Abdulhamid-Baghdadi/robot-milling-dust-extractor/cad/Suction_cup.SLDASM

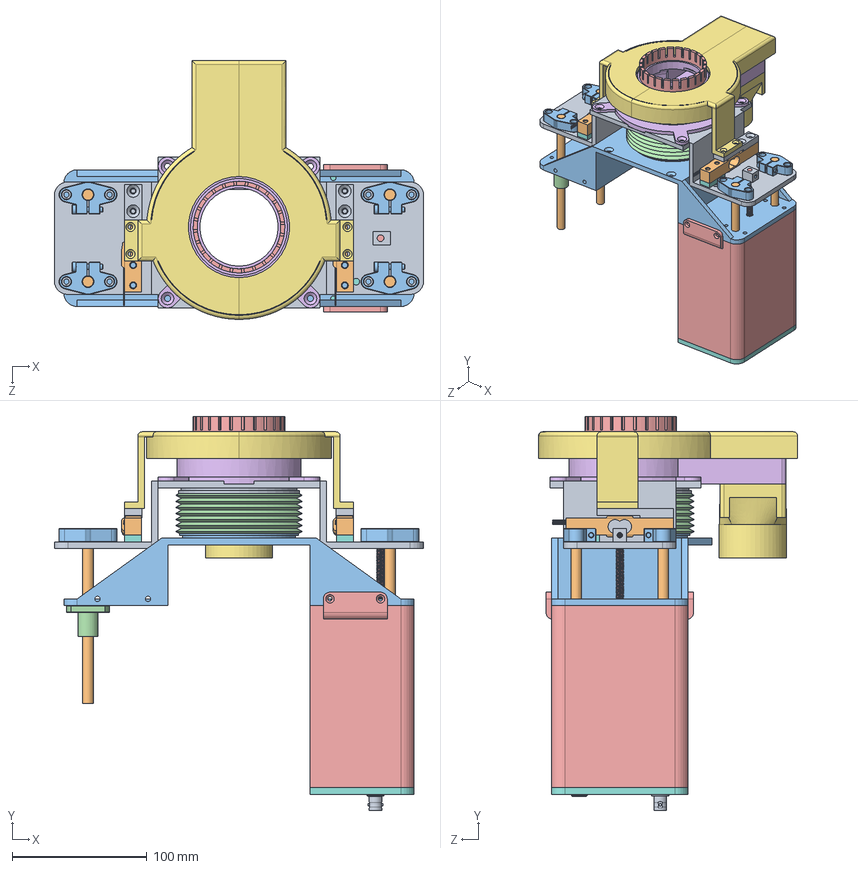
[picture p22: CAD file, 2026-10-20]
cad/Suction_cup.SLDASM
274.0 x 292.3 x 192.0 mm
Vacuum_stage
Rail x 4
Absaugung
LMH8UU x 4
Threaded Rod
LA351S12-A-UIEV.stp
Sensor
Weight_sensor_spacer x 2
Weight_sensor_carrier x 2
load_cell_sensor_FHD x 2
SHF8 x 4
TB6600 - Driver Motor de Passo 4A.stp
Lid
Dust_Inlet
Tube-connector
Electronics-lid
Amphenal_031_10_RFXG1
lumberg_1610_05.stp
m3_threaded_insert.stp
Tube
Besen
