Abdulhamid-Baghdadi/robot-milling-dust-extractor/cad/Vacuum_stage.SLDPRT

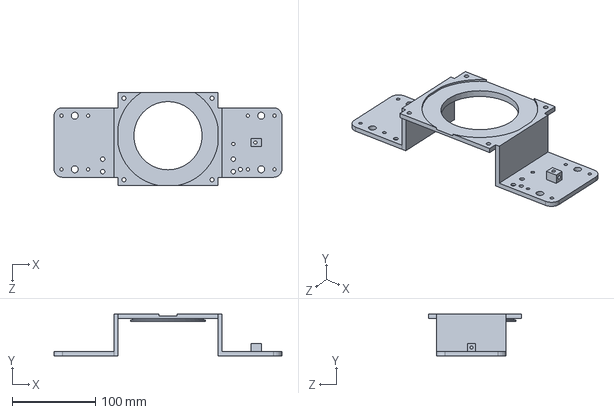
[picture p23: CAD file, 2026-10-20]
cad/Vacuum_stage.SLDPRT
274.0 x 50.0 x 112.0 mm
