Abdulhamid-Baghdadi/robot-milling-dust-extractor/cad/Tube-connector.SLDPRT

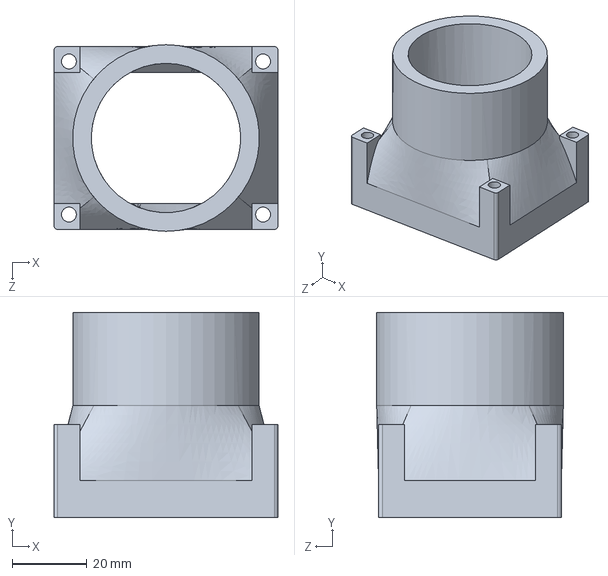
[picture p24: CAD file, 2026-10-20]
cad/Tube-connector.SLDPRT
60.0 x 55.0 x 50.0 mm
