Abdulhamid-Baghdadi/robot-milling-dust-extractor/cad/Sensor.SLDPRT

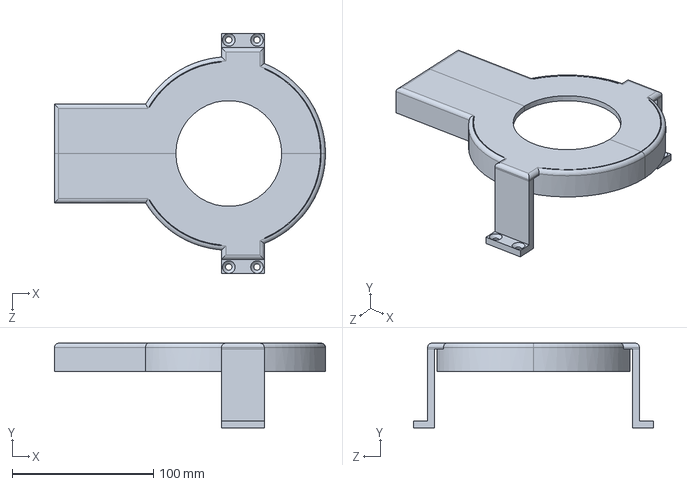
[picture p25: CAD file, 2026-10-20]
cad/Sensor.SLDPRT
192.0 x 60.0 x 170.0 mm
