Abdulhamid-Baghdadi/robot-milling-dust-extractor/cad/Tube.SLDPRT

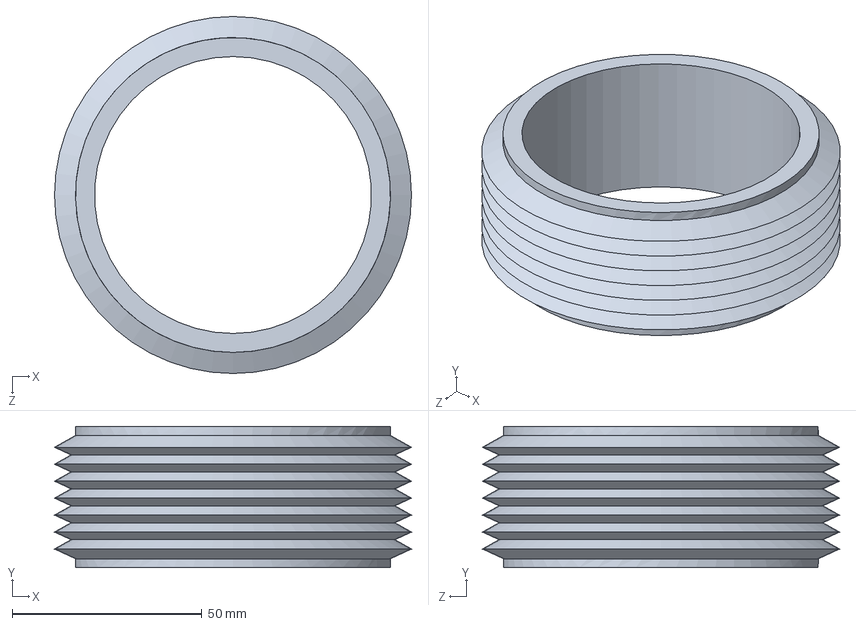
[picture p26: CAD file, 2026-10-20]
cad/Tube.SLDPRT
94.1 x 37.3 x 94.1 mm
