Abdulhamid-Baghdadi/robot-milling-dust-extractor/cad/Besen.SLDPRT

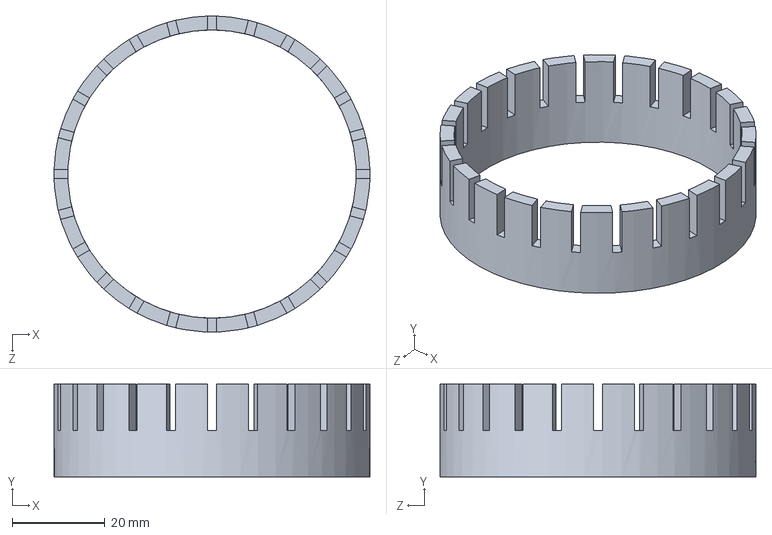
[picture p27: CAD file, 2026-10-20]
cad/Besen.SLDPRT
68.0 x 20.0 x 68.0 mm
