Abdulhamid-Baghdadi/robot-milling-dust-extractor/cad/Weight_sensor_carrier.SLDPRT

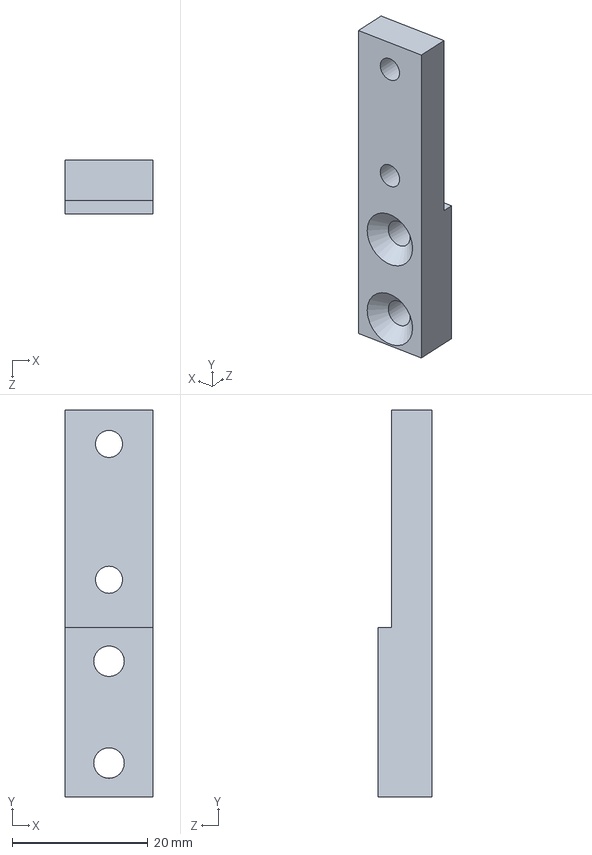
[picture p28: CAD file, 2026-10-20]
cad/Weight_sensor_carrier.SLDPRT
13.0 x 57.0 x 8.00 mm
