Abdulhamid-Baghdadi/robot-milling-dust-extractor/cad/Lid.SLDPRT

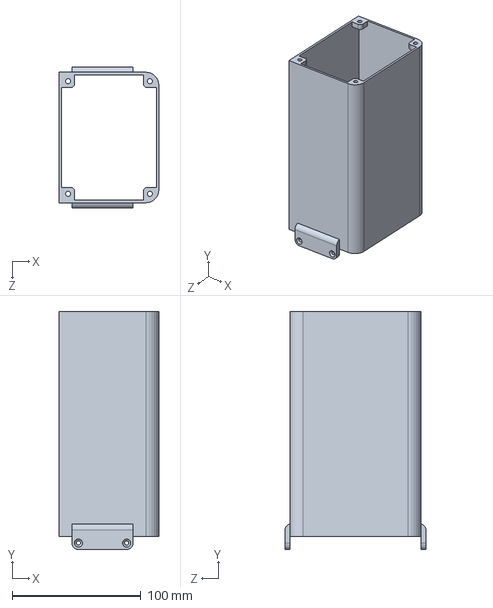
[picture p29: CAD file, 2026-10-20]
cad/Lid.SLDPRT
77.5 x 185.0 x 109.5 mm
