Abdulhamid-Baghdadi/robot-milling-dust-extractor/cad/Dust_Inlet.SLDPRT

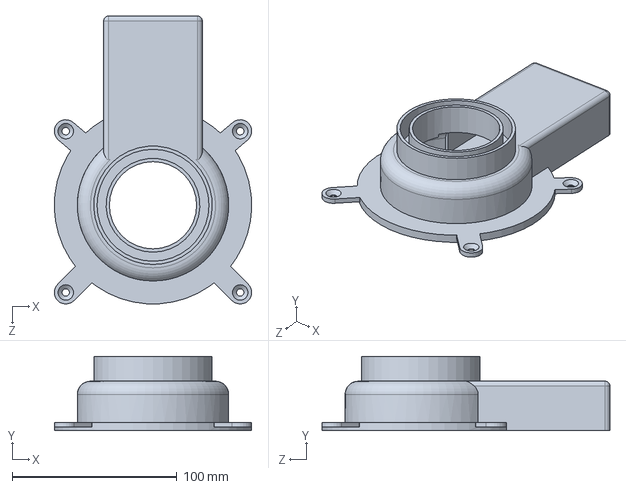
[picture p30: CAD file, 2026-10-20]
cad/Dust_Inlet.SLDPRT
120.0 x 45.0 x 175.0 mm
