Abdulhamid-Baghdadi/robot-milling-dust-extractor/cad/Rail.SLDPRT

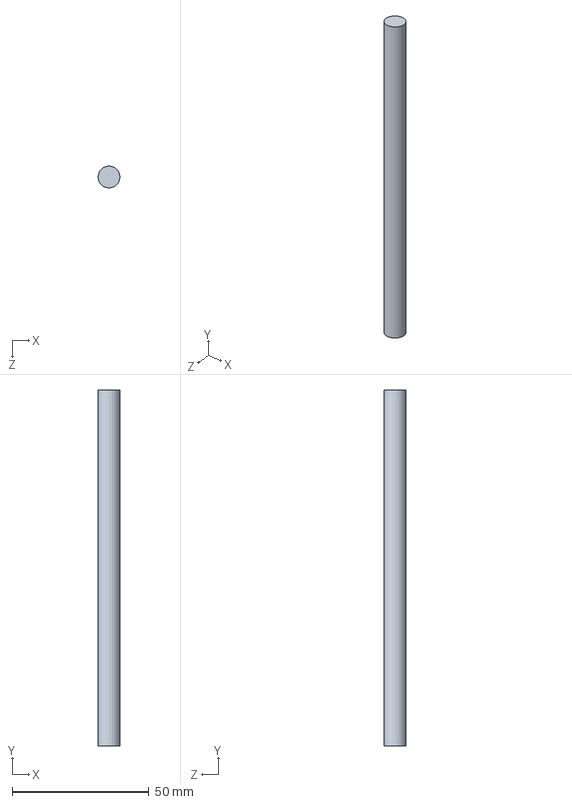
[picture p31: CAD file, 2026-10-20]
cad/Rail.SLDPRT
8.00 x 130.0 x 8.00 mm
