Abdulhamid-Baghdadi/robot-milling-dust-extractor/cad/Electronics-lid.SLDPRT

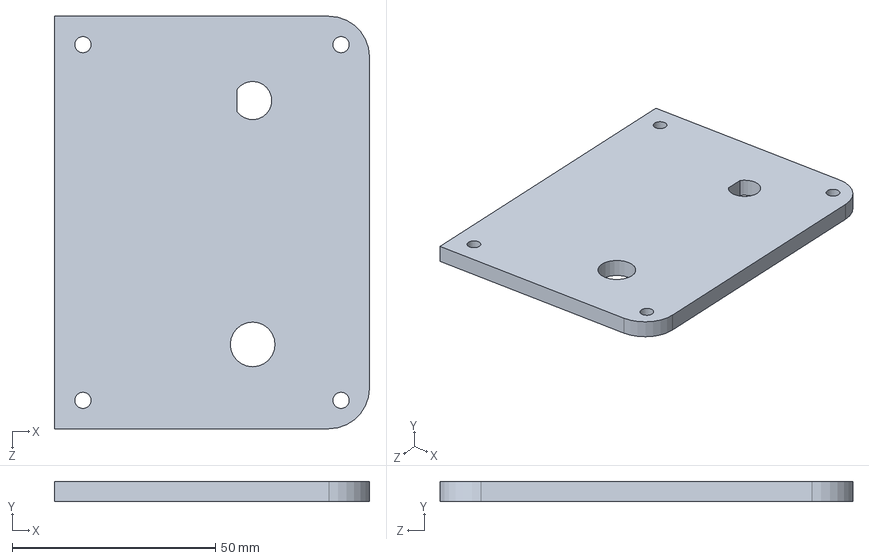
[picture p32: CAD file, 2026-10-20]
cad/Electronics-lid.SLDPRT
77.5 x 5.00 x 101.5 mm
