Abdulhamid-Baghdadi/robot-milling-dust-extractor/cad/Absaugung.SLDPRT

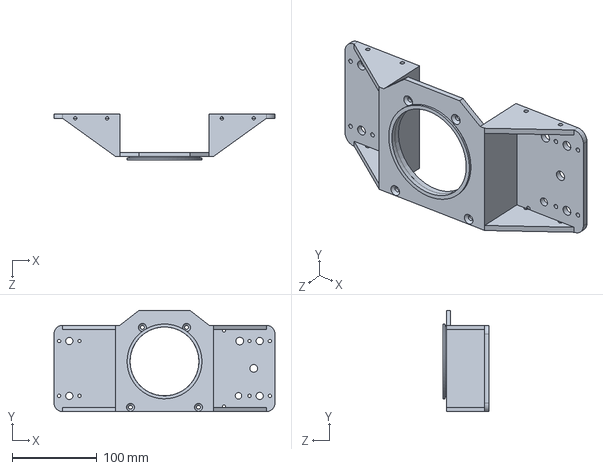
[picture p33: CAD file, 2026-10-20]
cad/Absaugung.SLDPRT
260.0 x 119.0 x 54.0 mm
