Abdulhamid-Baghdadi/robot-milling-dust-extractor/cad/Weight_sensor_spacer.SLDPRT

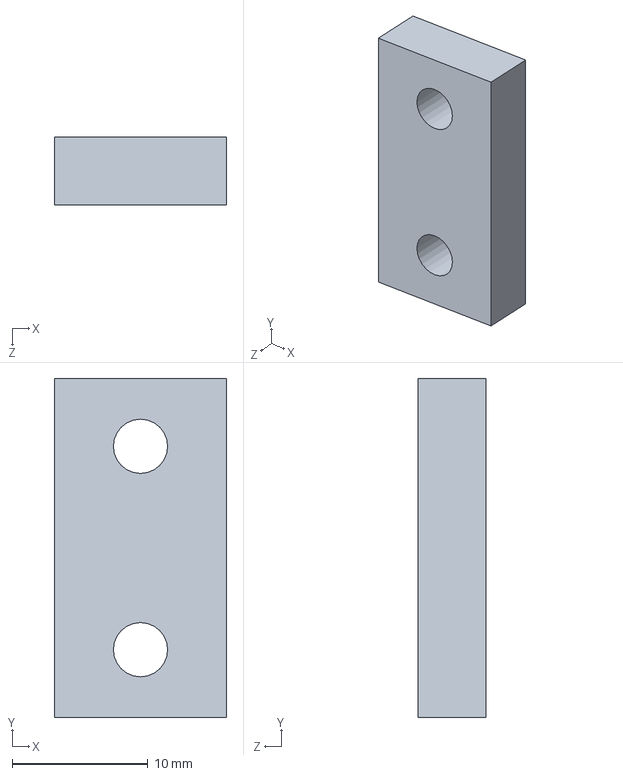
[picture p34: CAD file, 2026-10-20]
cad/Weight_sensor_spacer.SLDPRT
12.7 x 25.0 x 5.00 mm
