Abdulhamid-Baghdadi/robot-milling-dust-extractor/(list of files, cad)

Other CAD files:
cad/stl/Sensor.STL
cad/stl/Weight_sensor_carrier.STL
