Abdulhamid-Baghdadi/robot-milling-dust-extractor/docs/user-manual-de.pdf

# Bedienungsanleitung

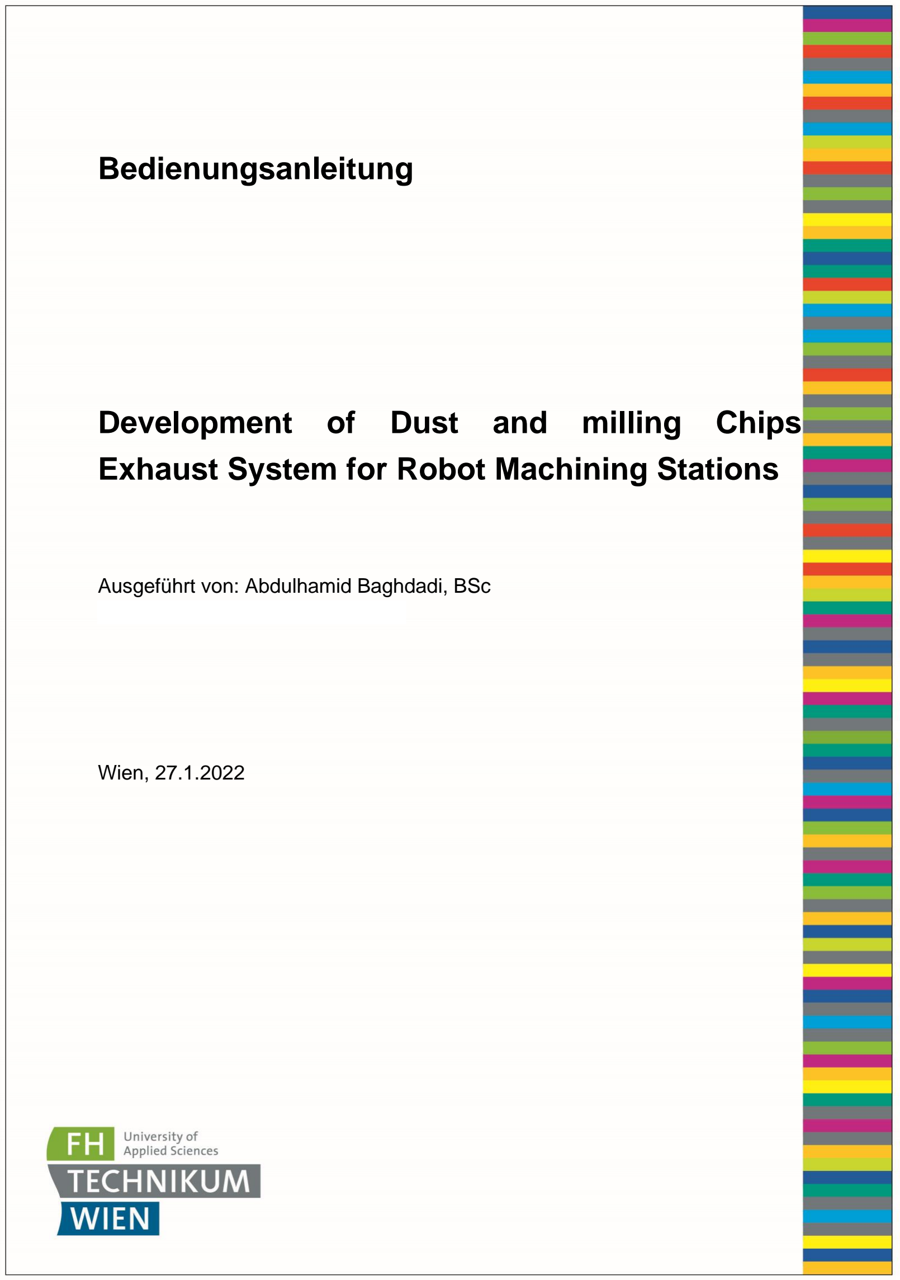
[picture p35: page 1]

# Development of Dust and milling Chips

# Exhaust System for Robot Machining Stations

Ausgeführt von: Abdulhamid Baghdadi, BSc

Wien, 27.1.2022

## Inhaltsverzeichnis

## 1 Montage des 3D gedruckten Models

In diesem Abschnitt sind die wichtigsten Schritte des Zusammenbauens der einzelnen Komponenten der Spänenabsaugung erläutert. Abbildung 1 Zeigt die Endform der Spänenabsaugung.

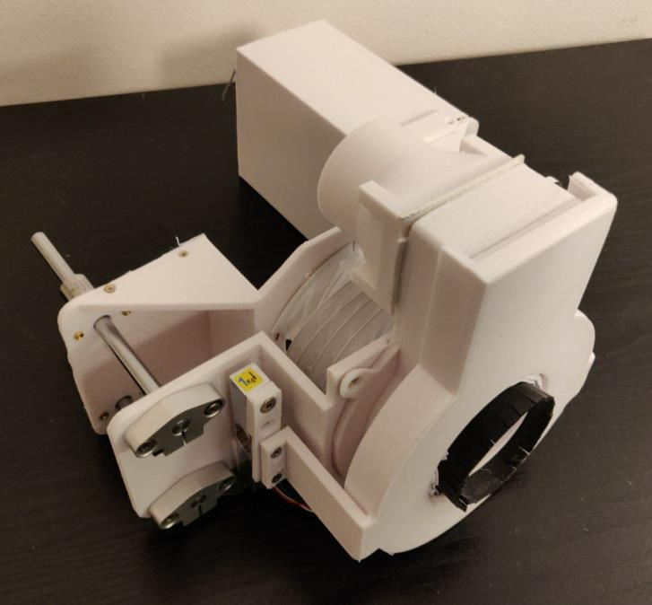
[picture p36: figure]

Abbildung 1: Zusammengebaute Spänenabsaugung

## 1.1 Hauptkörper

Die Linearführungen sowie der Schrittmotor und sein Kontroller sind mithilfe von M3 Gewindeeinsätze auf den Hauptkörper montiert.

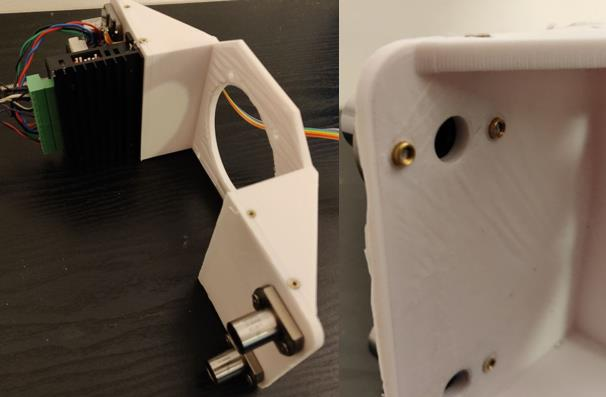
[picture p37: figure]

Abbildung 2: Hauptkörper

## 1.2 Bewegbarer Staubeinlass

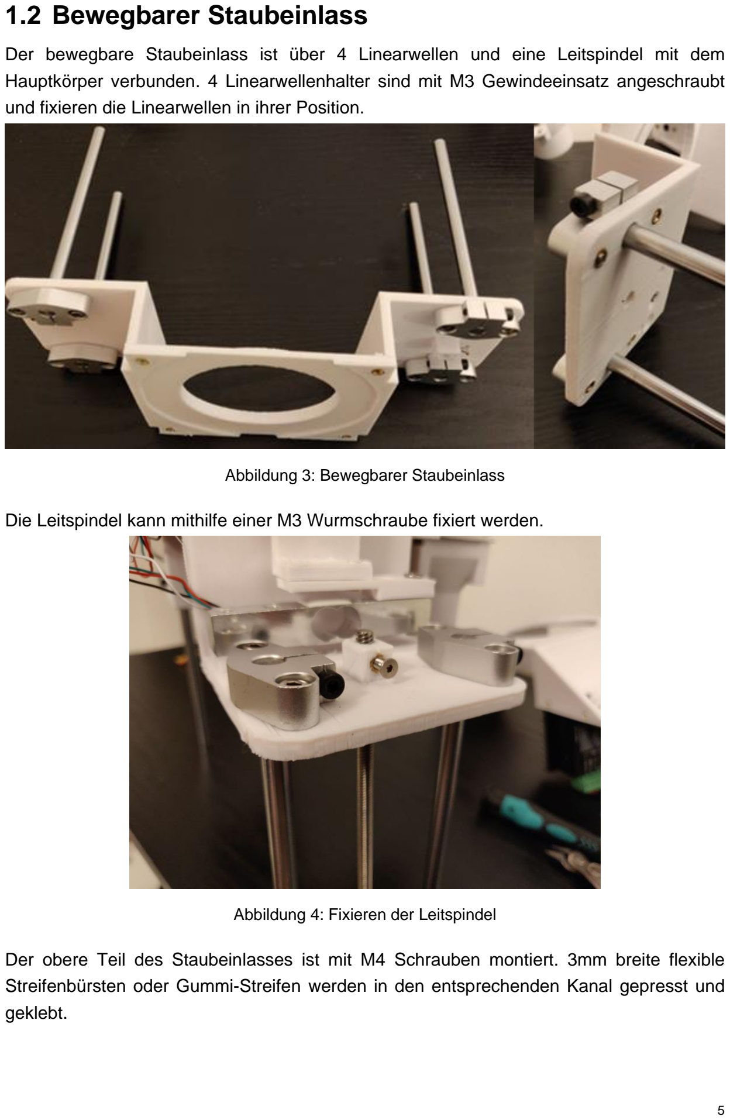
[picture p38: page 5]

Der bewegbare Staubeinlass ist über 4 Linearwellen und eine Leitspindel mit dem Hauptkörper verbunden. 4 Linearwellenhalter sind mit M3 Gewindeeinsatz angeschraubt und fixieren die Linearwellen in ihrer Position.

Abbildung 3: Bewegbarer Staubeinlass

Die Leitspindel kann mithilfe einer M3 Wurmschraube fixiert werden.

Abbildung 4: Fixieren der Leitspindel

Der obere Teil des Staubeinlasses ist mit M4 Schrauben montiert. 3mm breite flexible Streifenbürsten oder Gummi-Streifen werden in den entsprechenden Kanal gepresst und geklebt.

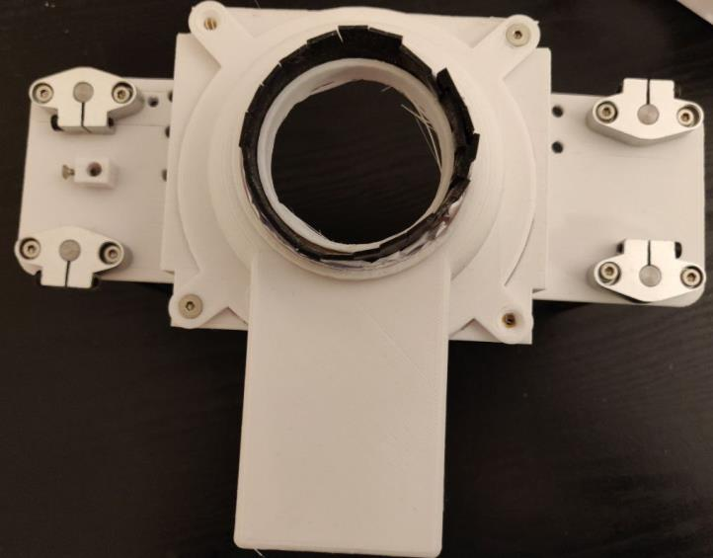
[picture p39: figure]

Abbildung 5: Flexible Streifenbürsten

## 1.3 Kraft Sensor

Der Kraftsensor wird mithilfe eines Spacers mit M5 schrauben angeschraubt. Der Kollisionsschutz wird schlussendlich mithilfe eines L-förmigen Adapters auf den Kraftsensor aufgebracht.

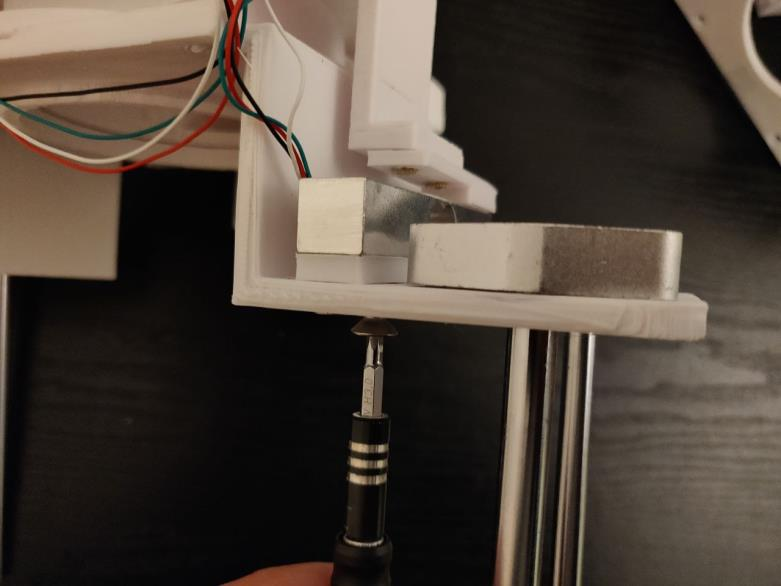
[picture p40: figure]

Abbildung 6: Kraftsensor und Kollisionsschutz

## 2 Elektrischer Schaltplan

Die elektrische Schaltung Besteht aus zwei Lochrasterplatinen, die miteinander mithilfe von Stiftleisten verbinden sind. Auf der ersten Platine befindet sich der ESP32, der den Schrittmotor steuert, während die zweite Platine einen Arduino Nano fürs Ablesen der gemessenen Werte in HX711-Gewichtssensor Verstärker beinhaltet.

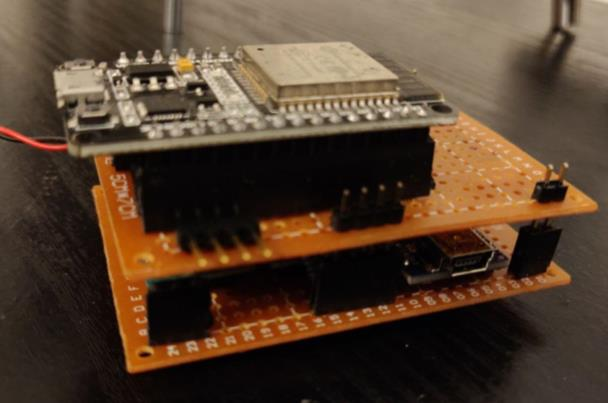
[picture p41: figure]

Abbildung 7: Elektrische Schaltung

Die elektronischen Komponenten sind entsprechend dem Schaltplan in Anhang A zu verbinden.

## 3 Programmieren

Die folgenden Programme sind auf die entsprechenden Microcontroller hochzuladen:

## 3.1 Arduino Nano Programmieren

Zuerst muss die HX711 Arduino Bibliothek mithilfe von Arduino Library Manager zu installieren.

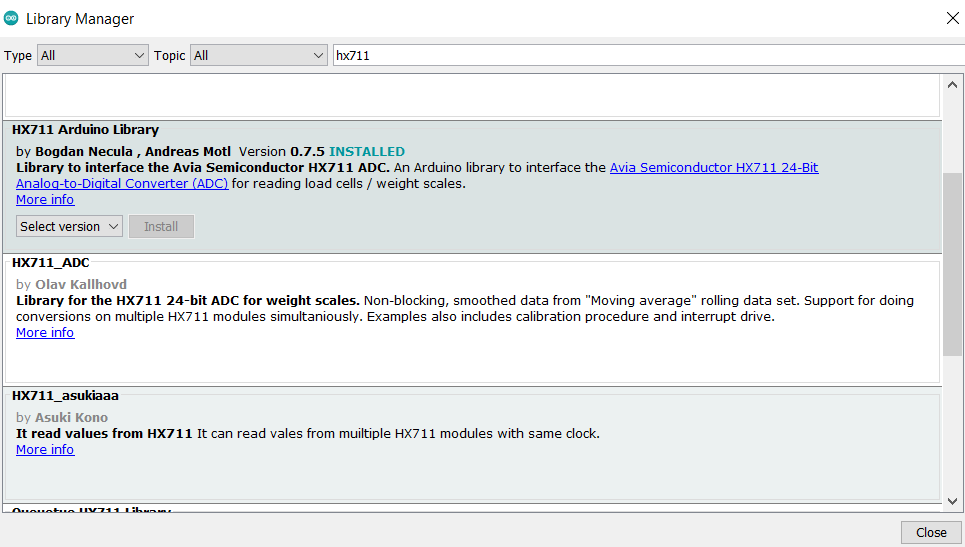
[picture p42: figure]

Der folgende Teil des Codes kann geändert werden, um die Schwellwerte für die starke
bzw. schwache Kollision zu definieren. Größere | Werte bedeuten, dass | die
Staubabsaugung einen gewissen Druck untergeht, bevor der Linearantrieb reagiert.

Danach wird die Datei “Exhaust_Nano_loadcell_reader.ino“ im Anhang auf den Arduino Nano hochgeladen.

## 3.2 ESP32 Programmieren

Die Accelstepper Arduino Bibliothek kann mithilfe von Arduino Library manager installiert werden.

// File name: Exhaust_Nano_loadcell_reader.ino #define SMALL_WEIGHT_THRESHOLD 15000 #define BIG_WEIGHT_THRESHOLD 40000

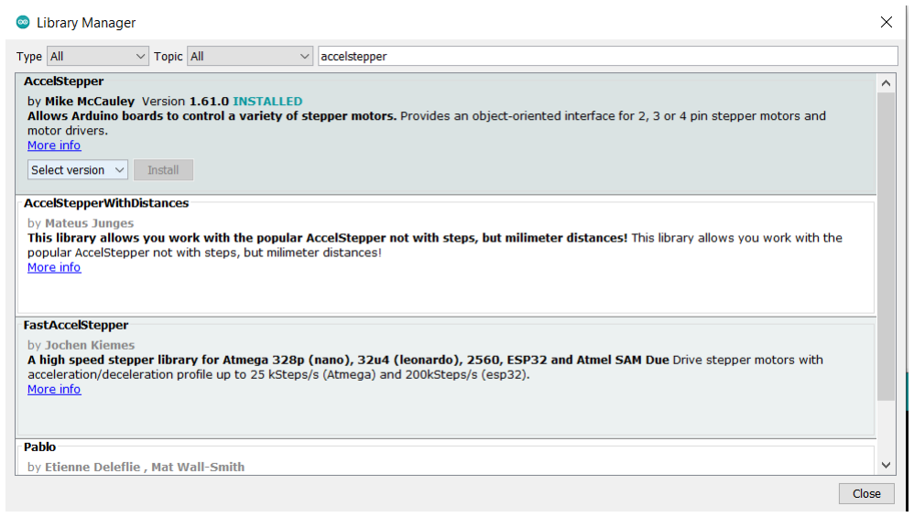
[picture p43: figure]

Der folgende Teil des Codes kann geändert werden, um die Anfangsposition bzw. Anfangsposition der Spänenabsaugung zu verändern

## 4 Inbetriebnahme

Nach erfolgreichem hochladen des Programms auf die entsprechenden Microcontroller, wird das analoge Ausgangssignal von KUKA KR C4 mit der BNC-Buchse in Abbildung 8 verbunden, um die Position der Staubabsaugung zu steuern. Es ist wichtig, den Wert des analogen Signal auf 5V zu beschränken, da höhere Werte den ESP-32 beschädigen können. Die DC-Buchse ist mit +12V Netzteil (max 1A) zu verbinden.

// File name: Exhaust_ESP32_main_code.ino #define STEPPER_MIN_VALUE 5000 #define STEPPER_MAX_VALUE 28000

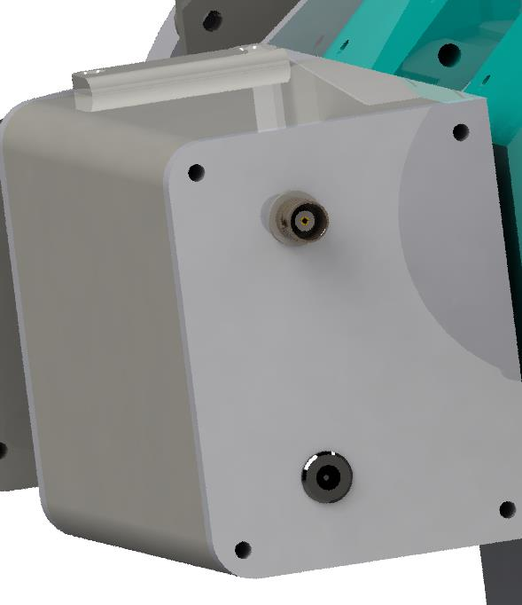
[picture p44: figure]

Abbildung 8: BNC Anschluss für den Steuersignal (oben) und DC-Buchse für die Versorgungsspannung.

## Abbildungsverzeichnis

Abbildung 7: BNC Anschluss für den Steuersignal (oben) und DC-Buchse für die

## Anhang A: Überschrift des ersten Anhangs

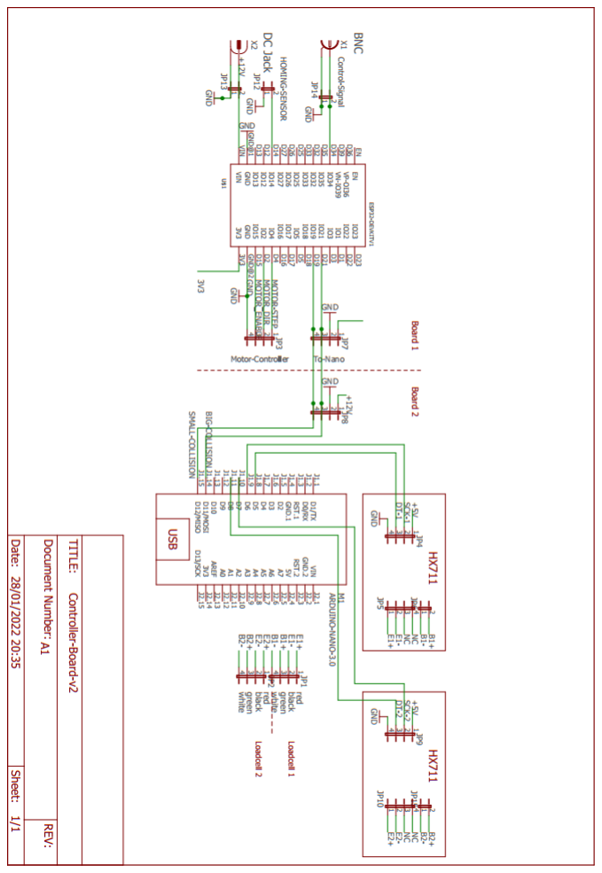
[picture p45: figure]
