Abdulhamid-Baghdadi/robot-milling-dust-extractor/hardware/Controller-Board-v2-schematic.pdf

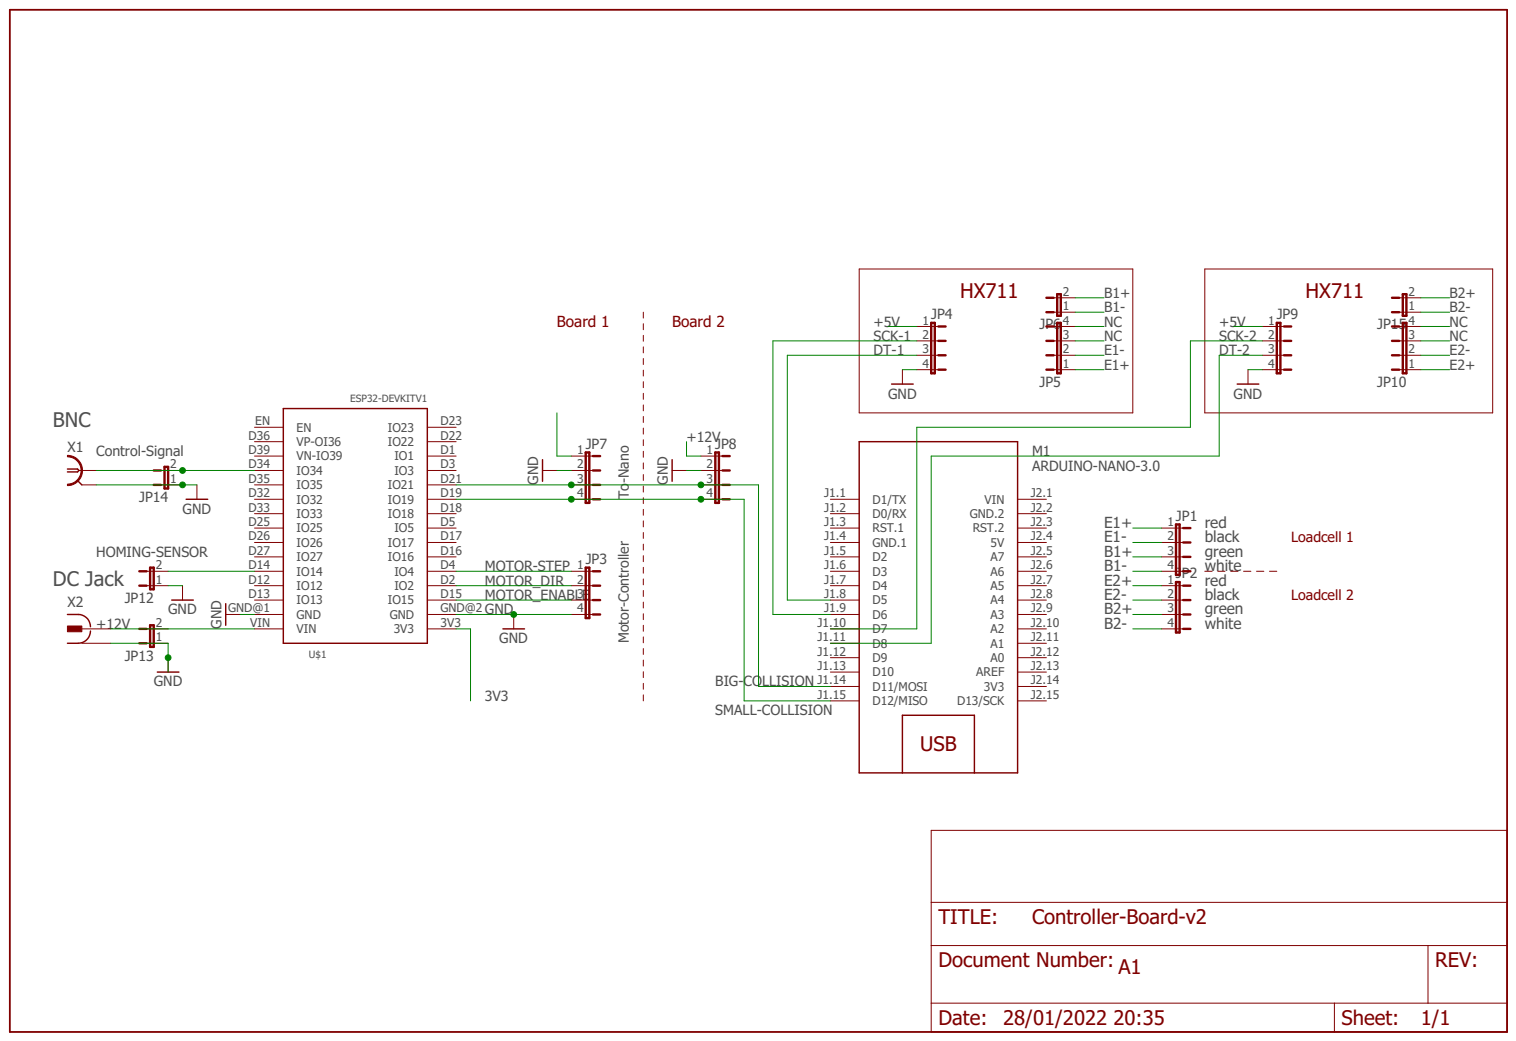
[picture p46: page 1]

Motor-Controller To-Nano

Document Number: A1 | REV:

Date: 28/01/2022 20:35 | Sheet: 1/1
