Abdulhamid-Baghdadi/robot-milling-dust-extractor/hardware/Controller-Board-v2.brd

## EAGLE design hardware/Controller-Board-v2.brd (2026-10-20)

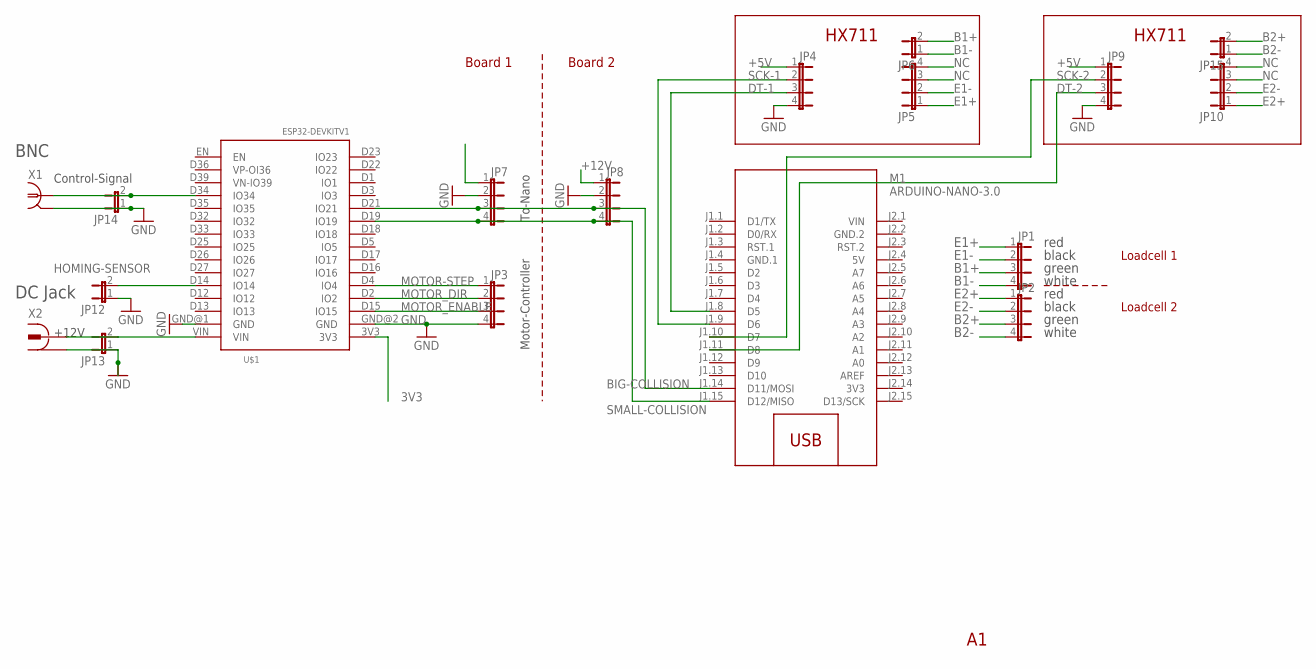
[picture p47: schematic Controller-Board-v2.sch]

Parts:
JP1, JP2, JP3, JP4, JP5, JP7, JP8, JP9, JP10: JP4E; JP4
JP6, JP12, JP13, JP14, JP15: JP1E; JP1
M1: ARDUINO-NANO-3.0
U$1: ESP32DEVKITV1; ESP32-DEVKITV1
X1: A1944-50; A1944
X2: 736880-49

Connections:
3V3: M1.J2.14 (3V3), U$1.3V3
5V: M1.J2.4 (5V)
+5V: JP4.1, JP9.1
+12V: JP7.1, JP8.1
B1+: JP1.3, JP6.2
B1-: JP1.4, JP6.1
B2+: JP2.3, JP15.2
B2-: JP2.4, JP15.1
BIG-COLLISION: JP7.3, JP8.3, M1.J1.14 (D11/MOSI), U$1.D21 (IO21)
DT-1: JP4.3, M1.J1.8 (D5)
DT-2: JP9.3, M1.J1.11 (D8)
E1+: JP1.1, JP5.1
E1-: JP1.2, JP5.2
E2+: JP2.1, JP10.1
E2-: JP2.2, JP10.2
GND: JP3.4, JP4.4, JP7.2, JP8.2, JP9.4, JP12.1, JP13.1, JP14.1, U$1.GND@1 (GND), U$1.GND@2 (GND), X1.2, X1.3 (2), X1.4 (2), X1.5 (2), X2.1, X2.1@1 (1), X2.1@2 (1)
GND.1: M1.J1.4 (GND.1)
GND.2: M1.J2.2 (GND.2)
HOMING-SENSOR: JP12.2, U$1.D14 (IO14)
MOTOR-STEP: JP3.1, U$1.D4 (IO4)
MOTOR_DIR: JP3.2, U$1.D2 (IO2)
MOTOR_ENABLE: JP3.3, U$1.D15 (IO15)
unnamed: JP14.2, U$1.D34 (IO34), X1.1
unnamed: JP13.2, U$1.VIN, X2.2
NC: JP5.3, JP5.4, JP10.3, JP10.4
SCK-1: JP4.2, M1.J1.9 (D6)
SCK-2: JP9.2, M1.J1.10 (D7)
SMALL-COLLISION: JP7.4, JP8.4, M1.J1.15 (D12/MISO), U$1.D19 (IO19)
VIN: M1.J2.1 (VIN)

Notes on the sheet:
+12V
Control-Signal
Motor-Controller
To-Nano
HX711
BNC
DC Jack
red
black
green
white
Board 1
Board 2
Loadcell 1
Loadcell 2

Board: 2 copper layers, 18 parts (0 on the bottom side), 25 nets, no tracks yet.
