Abdulhamid-Baghdadi/robot-milling-dust-extractor/firmware/motor_controller_esp32/definitions_esp32.h

#define motorInterfaceType 1
#define MOTOR_STEP 4
#define MOTOR_DIR 2
#define MOTOR_ENABLE 15
#define HOMING_SENSOR 26

#define BIG_WEIGHT 21
#define SMALL_WEIGHT 19

#define ANALOG_SIGNAL 34

#define STEPPER_MIN_VALUE 50
#define STEPPER_MAX_VALUE 28000
