Abdulhamid-Baghdadi/robot-milling-dust-extractor/(commit log)

2026-10-20 MMR3 dust extractor: firmware, Eagle schematic, CAD, docs and README
    [Absaugung.SLDPRT, Besen.SLDPRT, Controller-Board-v2.brd, Controller-Board-v2.sch, Dust_Inlet.SLDPRT, Electronics-lid.SLDPRT, Lid.SLDPRT, Rail.SLDPRT]
2026-10-20 README: lead with CAD and prototype images
